EngineeringbyRacingMotorsport/ES_HVAB_HW/HVAB.kicad_pcb

## KiCad design HVAB.kicad_pcb (2026-10-26)

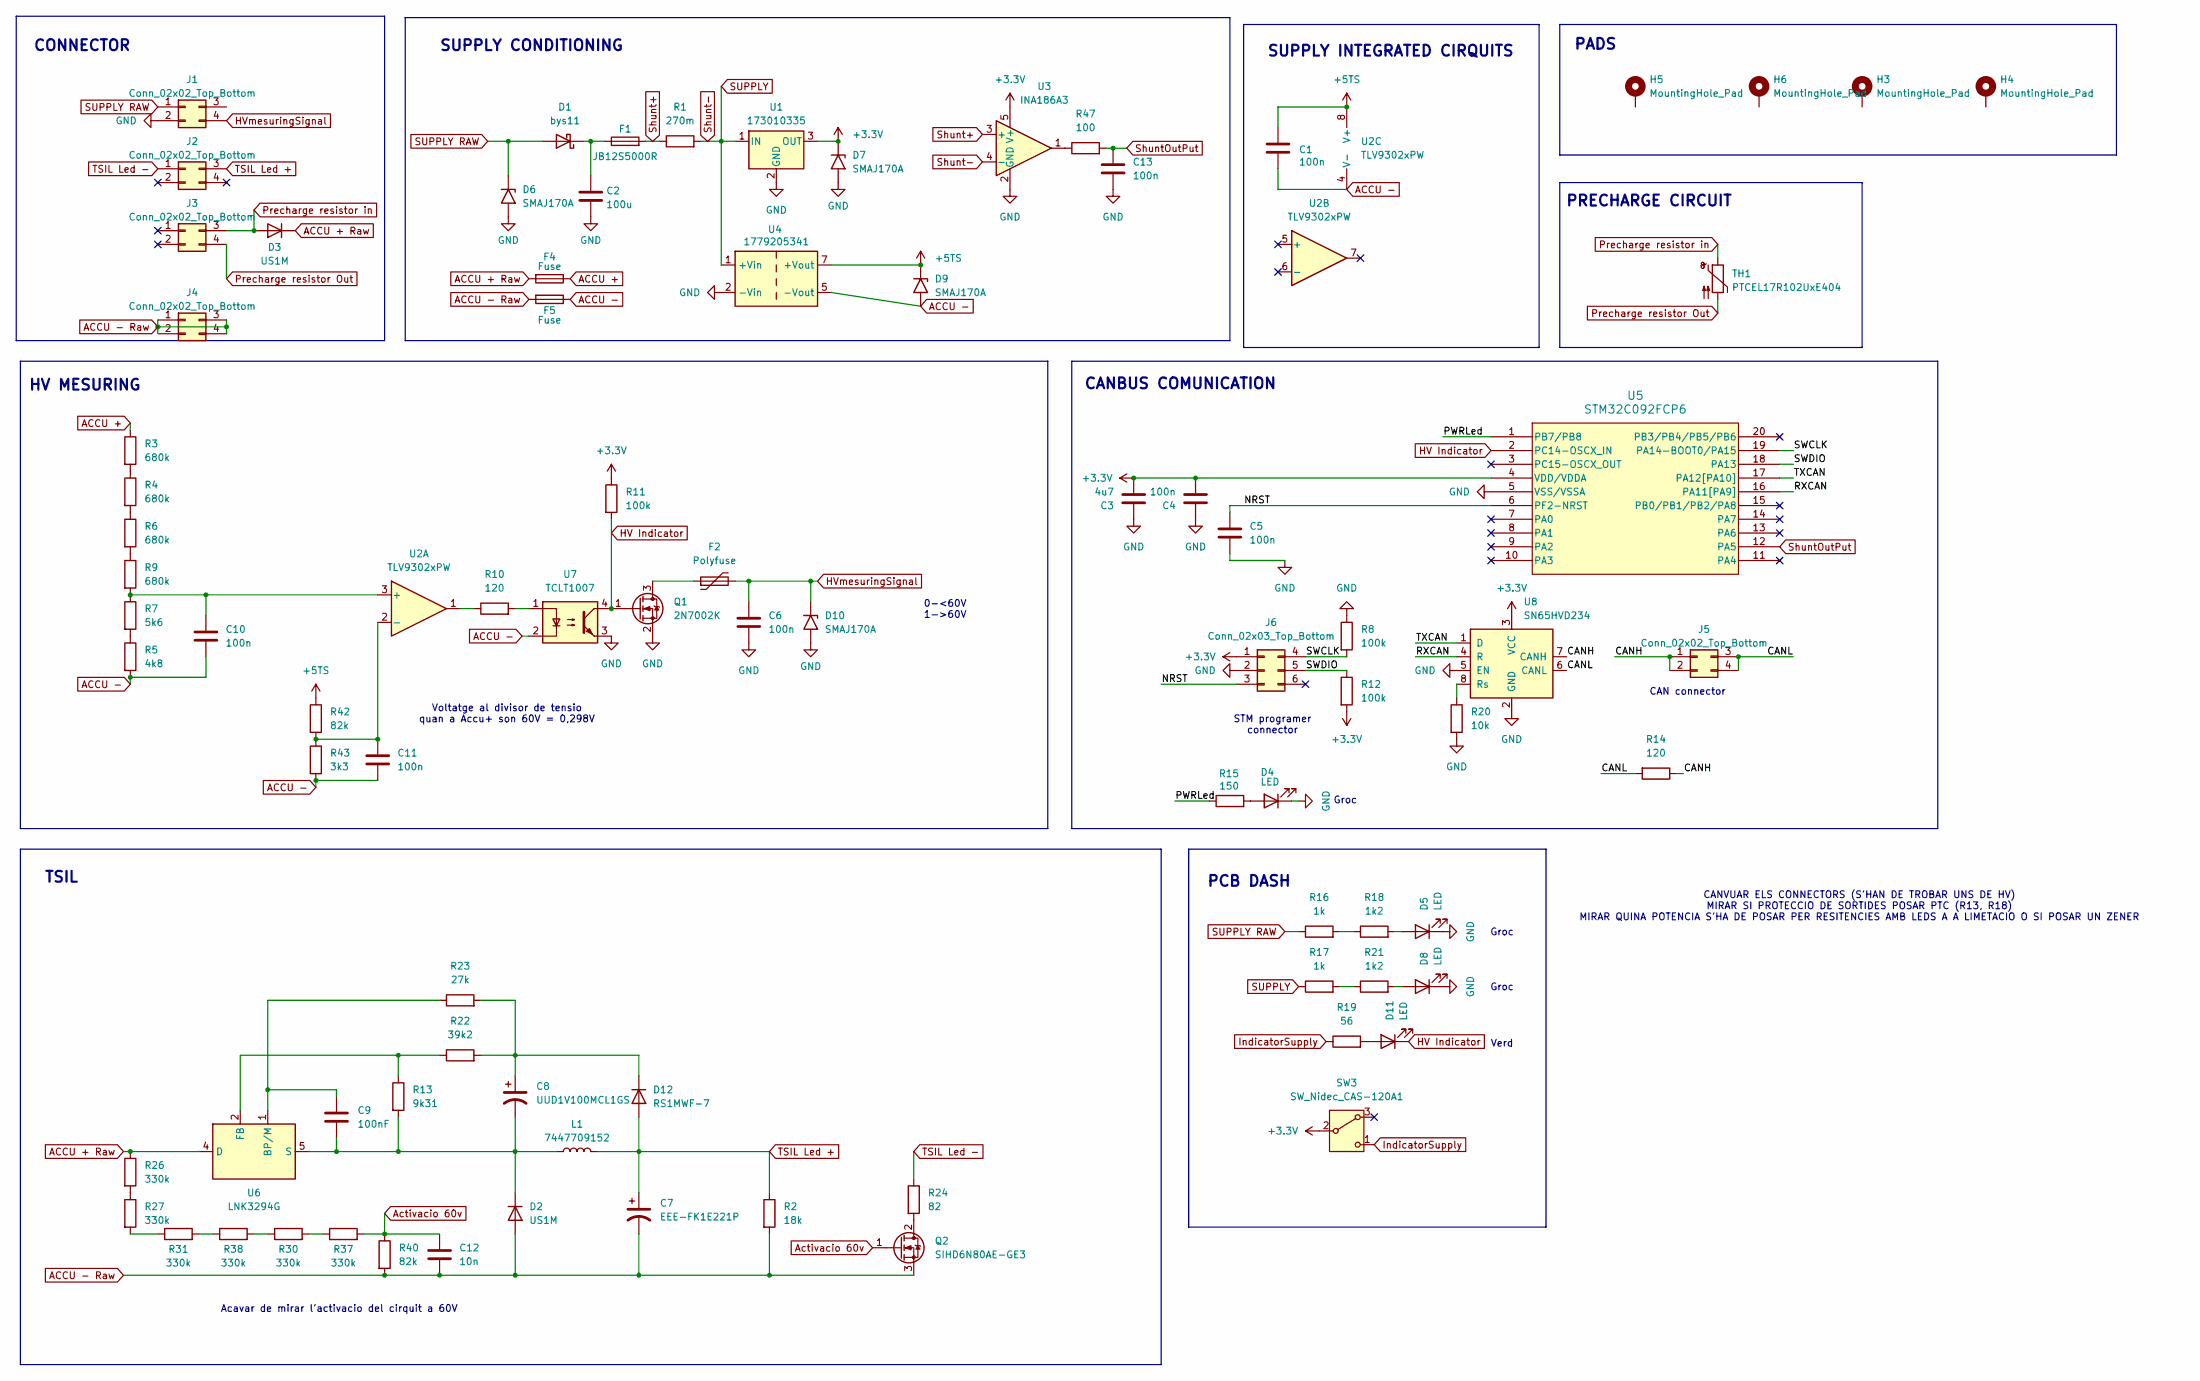
[picture p1: schematic HVAB.kicad_sch]

Parts:
C1, C4, C5, C6, C10, C11, C13: 100n; C_0603_1608Metric
C2: 100u; CP_Elec_10x10
C3: 4u7; C_0603_1608Metric
C7: EEE-FK1E221P; C_Elec_8x10.2
C8: UUD1V100MCL1GS; CP_Elec_5x5.8
C9: 100nF; C_0603_1608Metric
C12: 10n; C_0603_1608Metric
D1: bys11; D_SMA
D2, D3: US1M; D_SMA
D4, D5, D8, D11: LED; LED_0603_1608Metric
D6, D7, D9, D10: SMAJ170A; D_SMB
D12: RS1MWF-7; DIO_PMEG2010AEH_115
F1: JB12S5000R; Fuse_1206_3216Metric
F2: Polyfuse; Fuse_0603_1608Metric
F4, F5: Fuse; FUSE_0ACJ-1000-TE
H3, H4, H5, H6: MountingHole_Pad; MountingHole_3.5mm
J1, J5: Conn_02x02_Top_Bottom; Molex_Nano-Fit_105310-xx04_2x02_P2.50mm_Vertical
J2, J3, J4: Conn_02x02_Top_Bottom; 2068320401
J6: Conn_02x03_Top_Bottom; PinSocket_2x03_P1.27mm_Vertical_SMD
L1: 7447709152; L_Wuerth_WE-PD-Typ-LS
Q1: 2N7002K; SOT-23
Q2: SIHD6N80AE-GE3; TO-252-2
R1: 270m; R_0603_1608Metric
R2: 18k; R_0603_1608Metric
R3, R4, R6, R9: 680k; R_1206_3216Metric
R5: 4k8; R_0603_1608Metric
R7: 5k6; R_0603_1608Metric
R8, R11, R12: 100k; R_0603_1608Metric
R10, R14: 120; R_0603_1608Metric
R13: 9k31; R_0603_1608Metric
R15: 150; R_0603_1608Metric
R16, R17: 1k; R_1206_3216Metric
R18, R21: 1k2; R_1206_3216Metric
R19: 56; R_0603_1608Metric
R20: 10k; R_0603_1608Metric
R22: 39k2; R_0603_1608Metric
R23: 27k; R_0603_1608Metric
R24: 82; R_0603_1608Metric
R26, R27, R30, R31, R37, R38: 330k; R_1206_3216Metric
R40, R42: 82k; R_0603_1608Metric
R43: 3k3; R_0603_1608Metric
R47: 100; R_0603_1608Metric
SW3: SW_Nidec_CAS-120A1; Nidec_Copal_CAS-120A
TH1: PTCEL17R102UxE404; PTCEL17R501TBE
U1: 173010335; Converter_DCDC_RECOM_R-78E-0.5_THT
U2: TLV9302xPW; TSSOP-8_4.4x3mm_P0.65mm
U3: INA186A3; SOT-23-5
U4: 1779205341; Converter_DCDC_TRACO_TEA1-xxxxHI_THT
U5: STM32C092FCP6; TSSOP-20_4.4x6.5mm_P0.65mm
U6: LNK3294G; PowerIntegrations_SMD-8C
U7: TCLT1007; SOP-4_7.5x4.1mm_P2.54mm
U8: SN65HVD234; SOIC-8_3.9x4.9mm_P1.27mm

Connections:
+3.3V: C3.2, C4.2, D7.1 (A1), J6.1, R11.1, R12.2, SW3.2 (B), U1.3 (OUT), U3.5 (V+), U5.4 (VDD/VDDA), U8.3 (VCC)
+5TS: C1.1, D9.1 (A1), R42.1, U2.8 (V+), U4.7 (+Vout)
/CANH: J5.1, J5.2, R14.1, U8.7 (CANH)
/CANL: J5.3, J5.4, R14.2, U8.6 (CANL)
/NRST: C5.1, J6.3, U5.6 (PF2-NRST)
/PWRLed: R15.1, U5.1 (PB7/PB8)
/RXCAN: U5.16 (PA11[PA9]), U8.4 (R)
/SWCLK: J6.4, R8.2, U5.19 (PA14-BOOT0/PA15)
/SWDIO: J6.5, R12.1, U5.18 (PA13)
/TXCAN: U5.17 (PA12[PA10]), U8.1 (D)
ACCU +: F4.1, R3.1
ACCU + Raw: D3.1 (K), F4.2, R26.1, U6.4 (D)
ACCU -: C1.2, C10.2, C11.2, D9.2 (A2), F5.1, R5.2, R43.2, U2.4 (V-), U4.5 (-Vout), U7.2
ACCU - Raw: C7.2, C12.2, D2.2 (A), F5.2, J4.1, J4.2, J4.3, J4.4, Q2.3 (S), R2.2, R40.2
Activacio 60v: C12.1, Q2.1 (G), R37.2, R40.1
GND: C2.2, C3.1, C4.1, C5.2, C6.2, C13.2, D4.1 (K), D5.1 (K), D6.2 (A2), D7.2 (A2), D8.1 (K), D10.2 (A2), J1.2, J6.2, Q1.2 (S), R8.1, R20.2, U1.2 (GND), U3.2 (GND), U4.2 (-Vin), U5.5 (VSS/VSSA), U7.3, U8.2 (GND), U8.5 (EN)
HV Indicator: D11.1 (K), Q1.1 (G), R11.2, U5.2 (PC14-OSCX_IN), U7.4
HVmesuringSignal: C6.1, D10.1 (A1), F2.2, J1.4
IndicatorSupply: R19.1, SW3.1 (C)
unnamed: C2.1, D1.1 (K), F1.1
unnamed: C8.2, C9.2, D2.1 (K), L1.1, R13.2, U6.5 (S), U6.6 (S), U6.7 (S), U6.8 (S)
unnamed: D4.2 (A), R15.2
unnamed: D5.2 (A), R18.2
unnamed: D8.2 (A), R21.2
unnamed: D11.2 (A), R19.2
unnamed: C8.1, D12.1 (K), R22.2, R23.2
unnamed: F2.1, Q1.3 (D)
unnamed: Q2.2 (D), R24.2
unnamed: R3.2, R4.1
unnamed: R4.2, R6.1
unnamed: R5.1, R7.2
unnamed: R6.2, R9.1
unnamed: R10.1, U2.1
unnamed: R10.2, U7.1
unnamed: R16.2, R18.1
unnamed: R17.2, R21.1
unnamed: R26.2, R27.1
unnamed: R27.2, R31.1
unnamed: R30.1, R38.2
unnamed: R30.2, R37.1
unnamed: R31.2, R38.1
unnamed: R47.1, U3.1
unnamed: C10.1, R7.1, R9.2, U2.3 (+)
unnamed: C11.1, R42.2, R43.1, U2.2 (-)
unnamed: C9.1, R23.1, U6.1 (BP/M)
unnamed: R13.1, R22.1, U6.2 (FB)
unnamed: R20.1, U8.8 (Rs)
Precharge resistor Out: J3.4, TH1.2
Precharge resistor in: D3.2 (A), J3.3, TH1.1
SUPPLY: R1.2, R17.1, U1.1 (IN), U3.4 (-), U4.1 (+Vin)
SUPPLY RAW: D1.2 (A), D6.1 (A1), J1.1, R16.1
Shunt+: F1.2, R1.1, U3.3 (+)
ShuntOutPut: C13.1, R47.2, U5.12 (PA5)
TSIL Led +: C7.1, D12.2 (A), J2.3, L1.2, R2.1
TSIL Led -: J2.1, R24.1

Notes on the sheet:
PADS
CANBUS COMUNICATION
Groc
Verd
TSIL
SUPPLY INTEGRATED CIRQUITS
Voltatge al divisor de tensio quan a Accu+ son 60V = 0,298V
CANVUAR ELS CONNECTORS (S'HAN DE TROBAR UNS DE HV) MIRAR SI PROTECCIO DE SORTIDES POSAR PTC (R13, R18) MIRAR QUINA POTENCIA S'HA DE POSAR PER RESITENCIES AMB LEDS A A LIMETACIO O SI POSAR UN ZENER
CAN connector
PCB DASH
PRECHARGE CIRCUIT
SUPPLY CONDITIONING
0-<60V 1->60V
STM programer connector
CONNECTOR
HV MESURING
Acavar de mirar l'activacio del cirquit a 60V

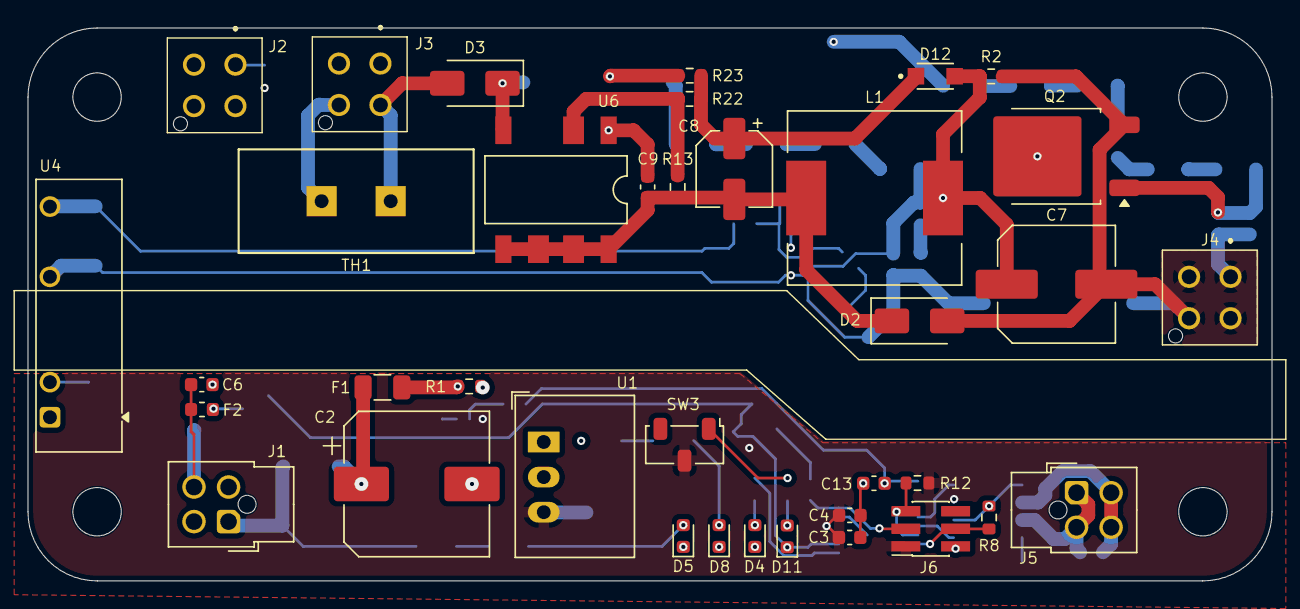
[picture p2: board HVAB.kicad_pcb from above]

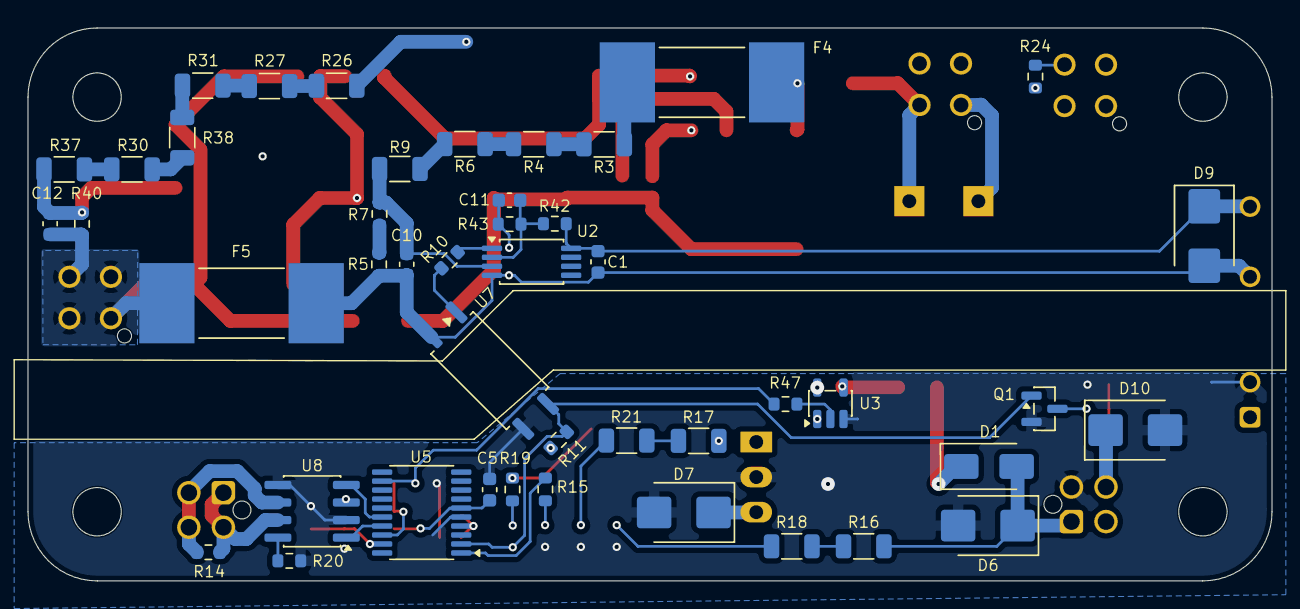
[picture p3: board HVAB.kicad_pcb from below]

Board: 4 copper layers, 90.0 x 40.0 mm, 86 parts (45 on the bottom side), 55 nets.
